amatelin/HG-Workshops/Workshop 1/src/img/01_breadboard.JPG

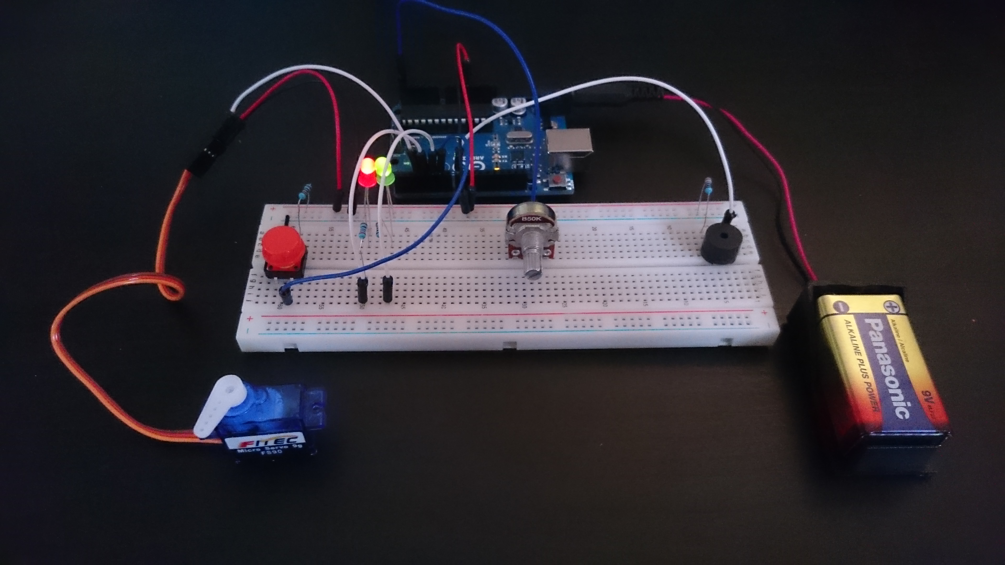
Workshop 1/src/img/01_breadboard.JPG
