amatelin/HG-Workshops/(list of files, cad)

Other CAD files:
Workshop 1/src/files/Frame.skp
Workshop 1/src/files/Frame_assembled.skp
