amatelin/HG-Workshops/(list of files, drawings)

Other design files:
Workshop 1/src/files/breadboard_fritzing.fzz
