amatelin/HG-Workshops/Workshop 1/src/files/Tea_stirrer.sch

## EAGLE design Workshop 1/src/files/Tea_stirrer.sch (2015-09-25)

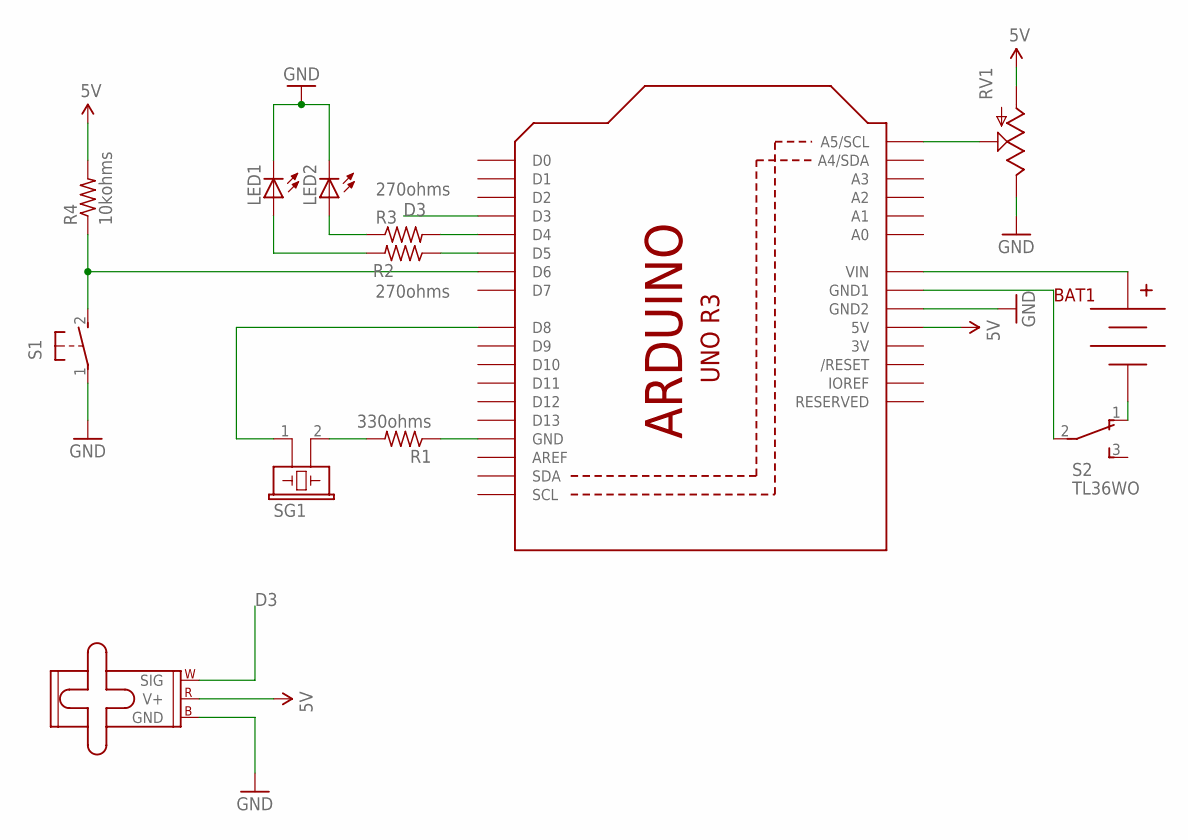
[picture p16: schematic Tea_stirrer.sch]

Parts:
BAT1: BC9VPC
LED1, LED2: LED5MM
M1: SMALL_SERVO; 1X03
R1: 330ohms; 0805-THM
R2, R3: 270ohms; 0805-THM
R4: 10kohms; 0805-THM
RV1: POT; ALPS_POT
S1: 31-XX; B3F-31XX
S2: TL36WO; TL3XWO
SG1: EFBAA40D101
U2: ARDUINOR3-BPLACE

Connections:
5V: M1.2 (V+), R4.2, RV1.P$3 (A), U2.5V
D3: M1.1 (SIG), U2.D3
GND: LED1.K (C), LED2.K (C), M1.3 (GND), RV1.P$1 (E), S1.1, U2.GND2
unnamed: R3.2, U2.D4
unnamed: R2.1, U2.D5
unnamed: LED2.A, R3.1
unnamed: LED1.A, R2.2
unnamed: R1.1, U2.GND
unnamed: R1.2, SG1.2
unnamed: SG1.1, U2.D8
unnamed: BAT1.V+, U2.VIN
unnamed: BAT1.V-, S2.1 (O)
unnamed: S2.2, U2.GND1
unnamed: RV1.P$2 (S), U2.A5 (A5/SCL)
unnamed: R4.1, S1.2 (S), U2.D6
