amatelin/HG-Workshops/(commit log)

2015-09-23 First commit : started arduino code for workshop
    Added stirring function and servo class
2015-09-23 Added status led, power led and timer button to the code
    Added a function to check if the button is pressed but needs improvement
    : we need to check for a state change (HIGH -> LOW -> HIGH) and not just
    ?LOW because it increments the timer way to fast.
2015-09-23 Added beeper function to code
    The beeper plays a G7 twice using the tone default function and a piezzo
    buzzer.
    [arduino_code.ino]
2015-09-23 Added function to get stirring time from potentiometer value
    The analog value from the potentiometer is re-based on a 0-10 range and
    then multiplied to get the corresponding time in milliseconds
2015-09-25 Adjusted servo values + Added comments + Changed led pins
2015-09-25 Added circuit schematic + fritzing breadboard + empty Instructions file
2015-09-25 Added images illustrating the whole process
    From part list -> breadboard -> assembly -> soldering -> final product
2015-09-25 Cleaned file structure + started working on Instructions
    [Tea_stirrer.sch, breadboard_fritzing.fzz]
2015-09-25 Improved instructions + added frame plans and rendering of frame assembled + minor improv in code
    [Frame.skp, Frame_assembled.skp]
